mickdassive/slime_minimax/README.md

# slime_minimax
hardware project based on slime vr full body trackers. im still working on adding support for aditonal chips. 
# hardware
as of right now the bno085 is confirmed working irl.
however im working on adding support for all other supported IMUs
