mickdassive/slime_minimax/kicad/bno085/bno085.kicad_pcb

## KiCad design kicad/bno085/bno085.kicad_pcb (2022-11-18)

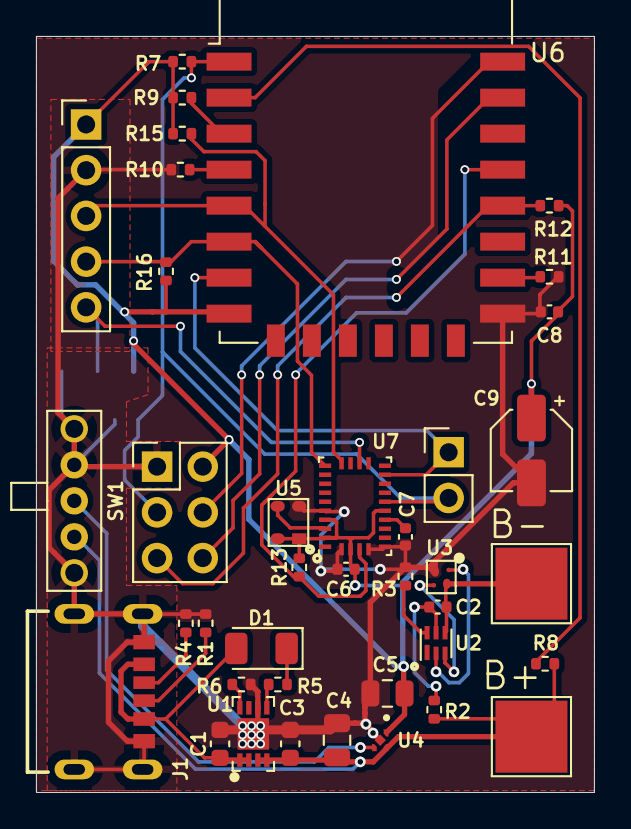
[picture p1: board bno085.kicad_pcb from above]

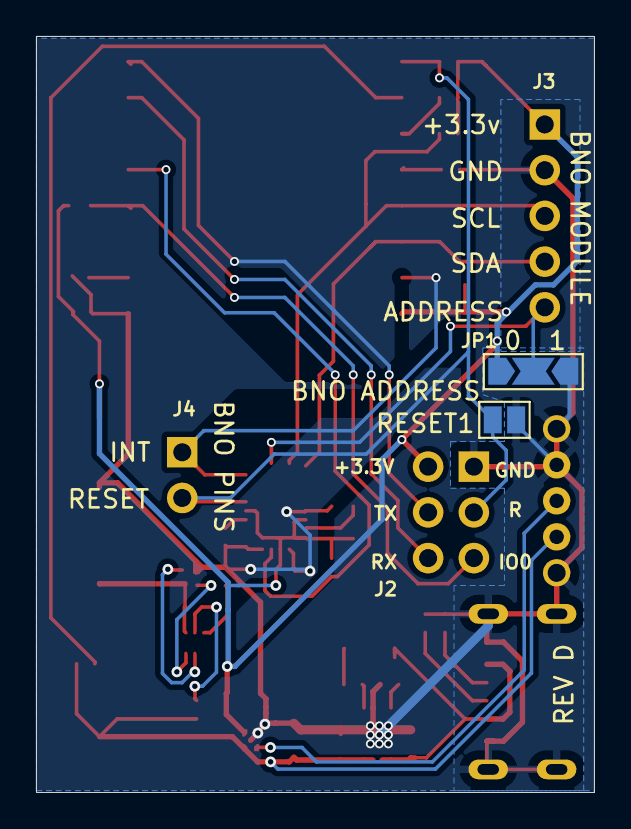
[picture p2: board bno085.kicad_pcb from below]

Board: 2 copper layers, 31.0 x 42.0 mm, 41 parts (2 on the bottom side), 28 nets.

Parts:
B+: TestPoint_Pad_4.0x4.0mm
B-: TestPoint_Pad_4.0x4.0mm
C1, C3: 4.7uf; C_0603_1608Metric
C2, C6, C7, C8: 100nf; C_0402_1005Metric
C4, C5: 1uf; C_0805_2012Metric
C9: 1uf; CP_Elec_4x4.5
D1: c-stat; D_1206_3216Metric
J1: USB4125-GF-A_REVA; GCT_USB4125-GF-A_REVA
J2: PinHeader_2x03_P2.54mm_Vertical
J3: PinHeader_1x05_P2.54mm_Vertical
J4: PinHeader_1x02_P2.54mm_Vertical
JP1: SolderJumper-3_P2.0mm_Open_TrianglePad1.0x1.5mm
R1, R4: 5.1k; R_0402_1005Metric
R2: 330; R_0402_1005Metric
R3, R13, R15, R16: 2.2k; R_0402_1005Metric
R5: 470; R_0402_1005Metric
R6: 2k; R_0402_1005Metric
R7, R9, R10, R11, R12: 10k; R_0402_1005Metric
R8: 180k; R_0402_1005Metric
RESET1: SolderJumper-2_P1.3mm_Open_Pad1.0x1.5mm
SW1: SW_SPDT; A107673
U1: dfn-8_wide
U2: BQ297xy; WSON-6_1.5x1.5mm_P0.5mm
U3: CSD85302L; 4-XFLGA
U4: NCP177BMX330TCG; VREG_NCP170AMX300TCG
U5: ASAK-32.7680KHZ-LRS-T; kc2016
U6: ESP-12E
U7: BNO085; LGA-28_5.2x3.8mm_P0.5mm

Connections:
+3.3V: C5.1, C6.1, C8.2, C9.1, J2.2, J3.1, JP1.3, R7.1, R9.1, R12.1, R13.1, R15.2, R16.2, U4.1 (OUT), U5.1 (INH), U5.4 (VCC), U6.8, U7.3 (VDD), U7.10 (CLKSEL0), U7.26 (XOUT32/CLKSEL1), U7.28 (VDDIO)
+5V: C1.1, D1.2 (A), J1.A9 (VBUS), J1.B9 (VBUS), U1.1, U1.2
+BATT: B+.1, C3.2, C4.1, R2.2, R8.1, SW1.3 (C), U1.3, U1.4, U4.4 (IN)
-BATT: C2.1, U2.4 (VSS), U3.2 (S2)
/ADC: R8.2, U6.2
/BAT_SENCE: C2.2, R2.1, U2.5 (BAT)
/BOOTN: R13.2, U6.19, U7.4 (BOOTN)
/CAP_BNO: C7.1, U7.9 (CAP)
/CC1: J1.A5 (CC1), R4.1
/CC2: J1.B5 (CC2), R1.1
/CH_STAT: R5.1, U1.5
/CLK_BNO: U5.3 (CLK), U7.27 (XIN32)
/ESP_EN: R9.2, U6.3
/GPIO0: J2.5, R12.2, U6.18
/GPIO15: R11.1, U6.16
/G_C: U2.2 (Cout), U3.1 (G1)
/G_D: U2.3 (Dout), U3.3 (G2)
/H_SCL: J3.3, R15.1, U6.5, U7.19 (H_SCL/SCK/RX)
/H_SDA: J3.4, R16.1, U6.6, U7.20 (H_SDA/H_MISO/TX)
/INT: J4.1, U6.7, U7.14 (H_INTN)
/MOSI: J3.5, JP1.2, U7.17 (SA0/H_MOSI)
/REG_EN: SW1.2 (B), U4.3 (EN)
/RESET: J2.3, J4.2, R7.2, RESET1.2, U6.1, U7.11 (NRST)
/RX: J2.6, U6.21
/TX: J2.4, U6.22
/V-: R3.2, U2.6 (V-)
GND: C1.2, C3.1, C4.2, C5.2, C6.2, C7.2, C8.1, C9.2, J1.A12 (GND), J1.B12 (GND), J1.S1 (SHIELD), J1.S2 (SHIELD), J1.S3 (SHIELD), J1.S4 (SHIELD), J2.1, J3.2, JP1.1, R1.2, R3.1, R4.2, R6.1, R10.2, R11.2, RESET1.1, SW1.1 (A), SW1.4, SW1.5, U1.6, U1.9, U3.4 (S1), U4.2 (GND), U4.5, U5.2 (GND), U6.15, U7.2 (GND), U7.5 (PS1), U7.6 (PS0/WAKE), U7.25 (GNDIO)
unnamed: D1.1 (K), R5.2
