mickdassive/slime_minimax/(commit log)

2022-11-16 added kicad files
    [slime-B_Cu.gbr, slime-B_Mask.gbr, slime-B_Paste.gbr, slime-B_SilkS.gbr, slime-Edge_Cuts.gbr, slime-F_Cu.gbr, slime-F_Mask.gbr, slime-F_Paste.gbr]
2022-11-16 updated titel block
    [slime.kicad_sch]
2022-11-16 changed naming conventions
    [bno085-v0.1.kicad_pcb, bno085.kicad_pcb, bno085.kicad_sch, bno085.sch, slime-v0.1.kicad_pcb, slime.kicad_pcb, slime.kicad_sch, slime.sch]
2022-11-16 setting things up for other chips
    [bmi160.kicad_pcb, bmi160.kicad_sch, bmi160.sch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]
2022-11-17 added Datasheets and updated shimatics for bno085 board
    [bno085.kicad_sch]
2022-11-17 added basic support for bmi160, it shold work i haven had a chance to test thogh
    [bmi160.kicad_pcb, bmi160.kicad_sch]
2022-11-17 removed old/redundant files
    [bno085-v0.1.kicad_pcb]
2022-11-17 added adional dicrectorys for all chips supperted by slimevr
    [bno055.kicad_pcb, bno055.kicad_sch, bno055.sch, icm20948.kicad_pcb, icm20948.kicad_sch, icm20948.sch, mpu2950.kicad_pcb, mpu2950.kicad_sch]
2022-11-17 added bno055 support unfortunately some componts ha to be mouted on the back as they were to lage for the front
    [bno055.kicad_pcb, bno055.kicad_sch]
2022-11-17 removed useless files
    [slime-B_Cu.gbr, slime-B_Mask.gbr, slime-B_Paste.gbr, slime-B_SilkS.gbr, slime-Edge_Cuts.gbr, slime-F_Cu.gbr, slime-F_Mask.gbr, slime-F_Paste.gbr]
2022-11-17 stated work on mpu9250 not finnished
    [mpu9250.kicad_pcb, mpu9250.kicad_sch, mpu9250.sch]
2022-11-18 made minor cahnges to bno085 schimatic + pcb to better reflect the real world version
    [bno085.kicad_pcb, bno085.kicad_sch]
2022-11-18 added support for mpu9250
    [mpu9250.kicad_pcb, mpu9250.kicad_sch]
2022-11-22 addded firmware working out bugs rn
    [caseV0.FCStd]
2022-12-02 migrateing devopment to dev brantch
    [bmi160.kicad_pcb, bmi160.kicad_sch, bmi160.sch, bno055.kicad_pcb, bno055.kicad_sch, bno055.sch, icm20948.kicad_pcb, icm20948.kicad_sch]
2022-12-02 migrateing to dev brantch
    [caseV0.FCStd]
